pratyanshupandey/ESW-Project/README.md

# ESW-Project

docs folder contains the documentation for the project.

sketch folder containst the final code.
ESP32.ino is the final code and other files are intermediate and helper files.
