pratyanshupandey/ESW-Project/(commit log)

2021-10-02 pwm check
2021-10-02 Including better pwm library
